SkydivinGirl/SaV64/README.md

# SaV64
Commodore VIC-20, Commodore 64, and Commodore Plus/4 Over-Voltage Protection

Jointly designed by Heather Kent and Fredric Blåholtz

Electrical Design and PCB Layout: Fredric Blåholtz
