SkydivinGirl/SaV64/PCBs/Oops v3/ReadMe.txt

Optocoupler Daughter Board for SaV64 v1.33 PCB
