SkydivinGirl/SaV64/Documents/Trip Point Settings.txt

5.628V = 43K
5.573V = 43K + (698 Parallel 1.8K = 503)
5.552V = 43K + 698
5.437V = 43K + 1.8K
