SkydivinGirl/SaV64/PCBs/v1.33/ReadMe.txt

SaV64 v1.33 PCB
Requires Oops v3 Optocoupler Daughter Board
