SkydivinGirl/SaV64/Images/20150811_192422.jpg

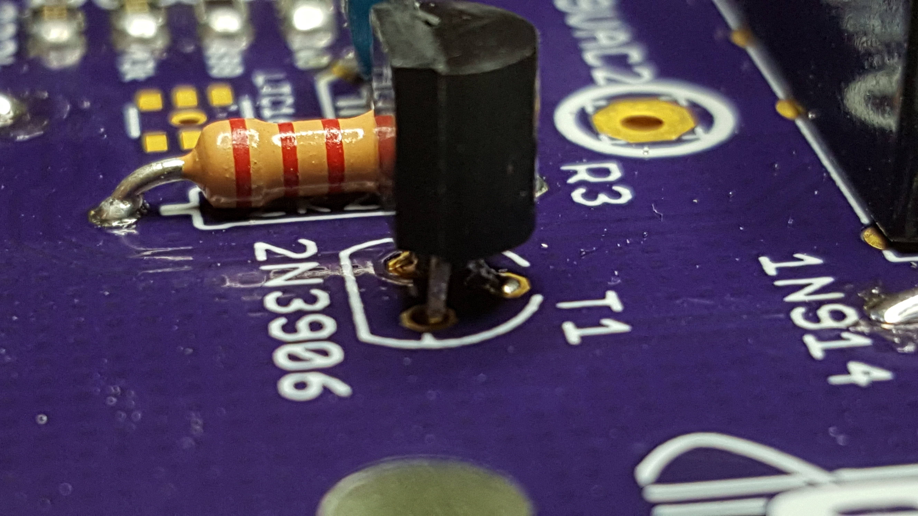
Images/20150811_192422.jpg
