SkydivinGirl/SaV64/Images/20150816_183255.jpg

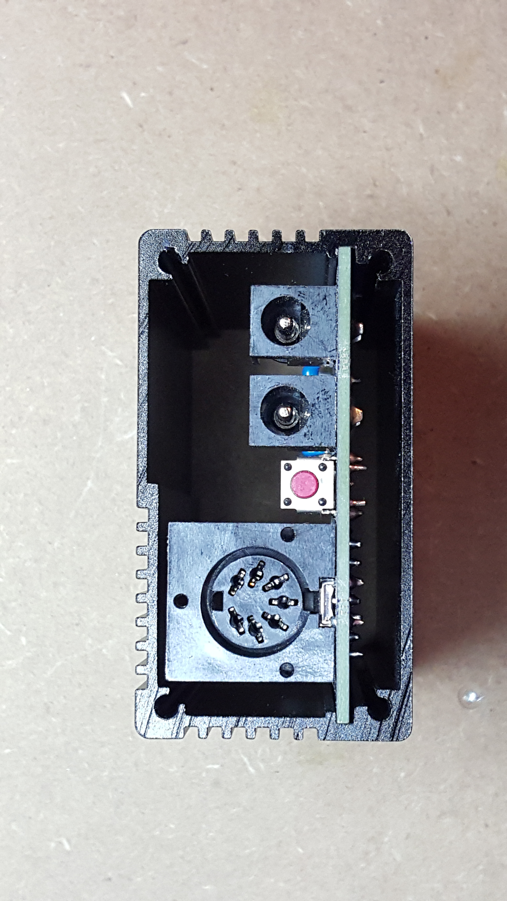
Images/20150816_183255.jpg
