SkydivinGirl/SaV64/Images/20150816_202436.jpg

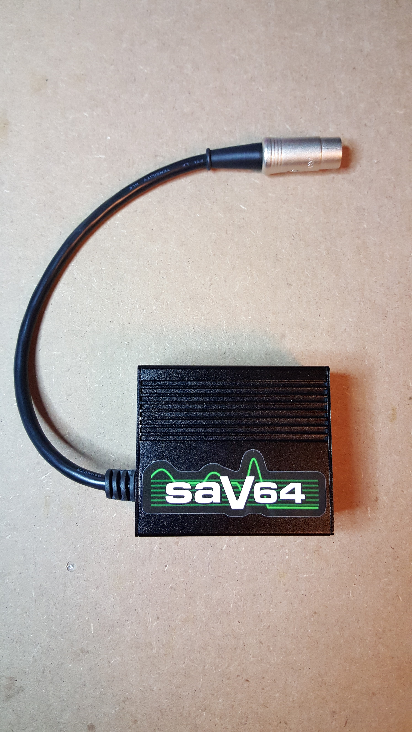
Images/20150816_202436.jpg
