SkydivinGirl/SaV64/Images/20150816_202522.jpg

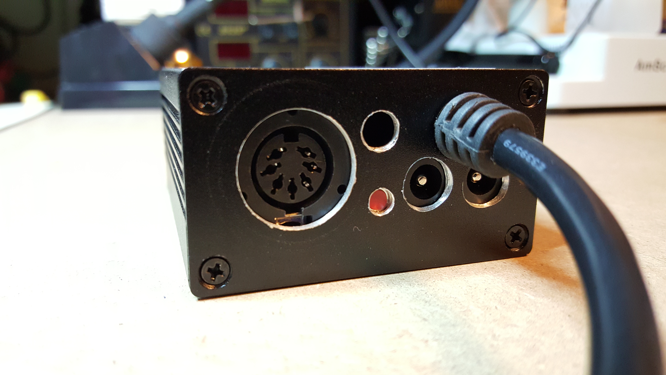
Images/20150816_202522.jpg
