SkydivinGirl/SaV64/Images/20150819_134136_original.jpg

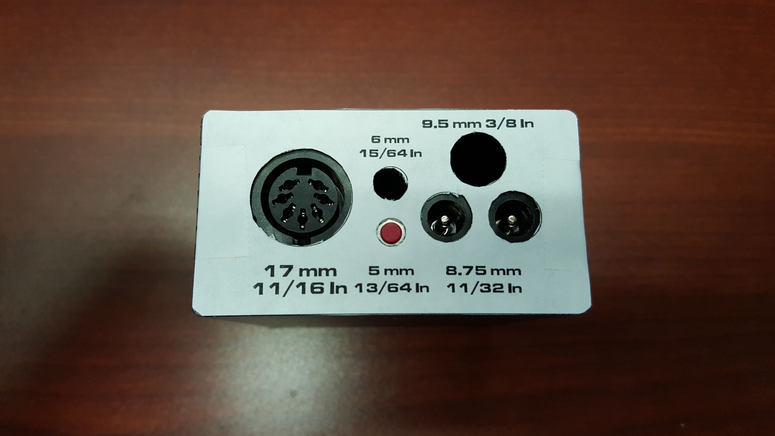
Images/20150819_134136_original.jpg
