SkydivinGirl/SaV64/Images/End Plate Labels/Bottom Plate Label 5.44 with Polarity.png

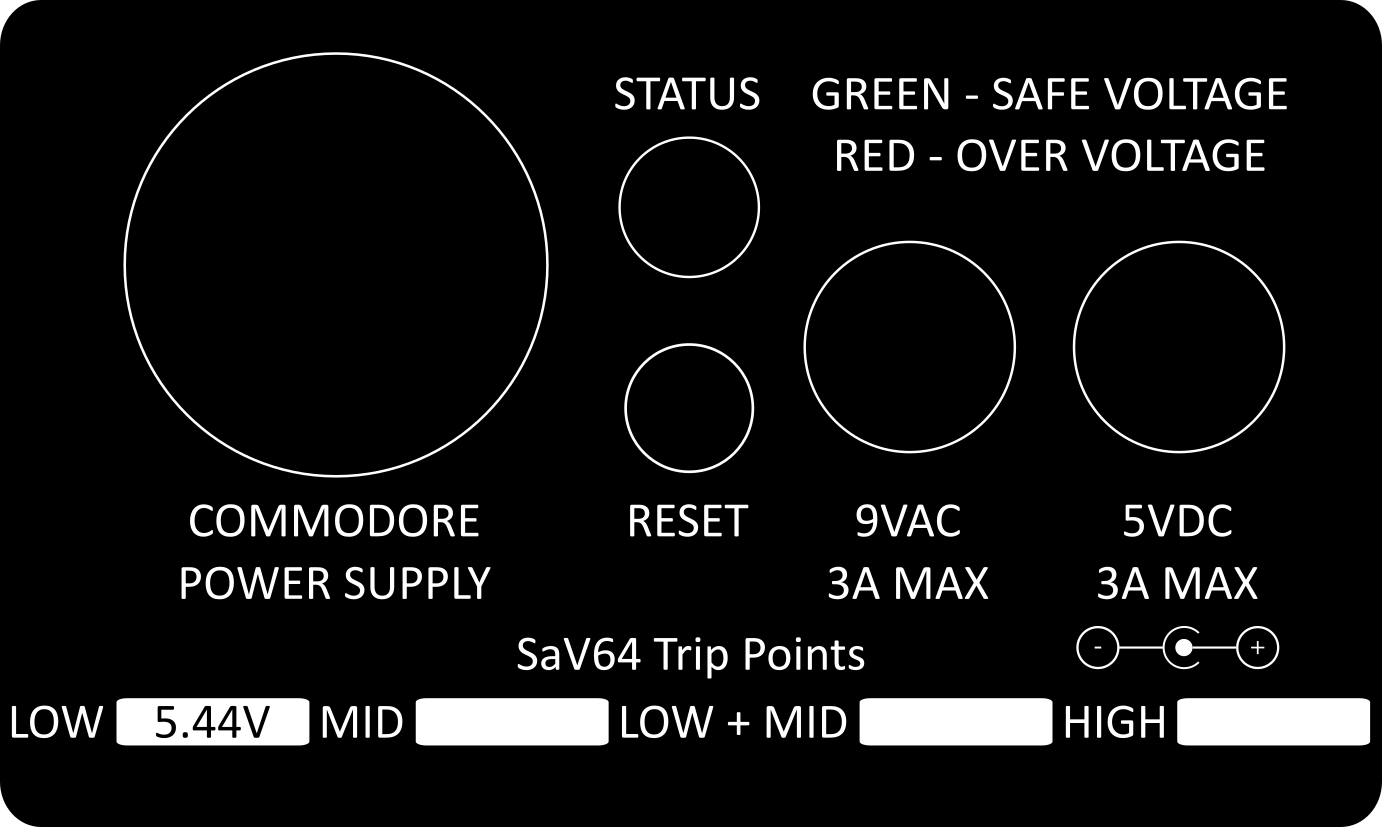
Images/End Plate Labels/Bottom Plate Label 5.44 with Polarity.png
