SkydivinGirl/SaV64/Images/End Plate Template (With Image).jpg

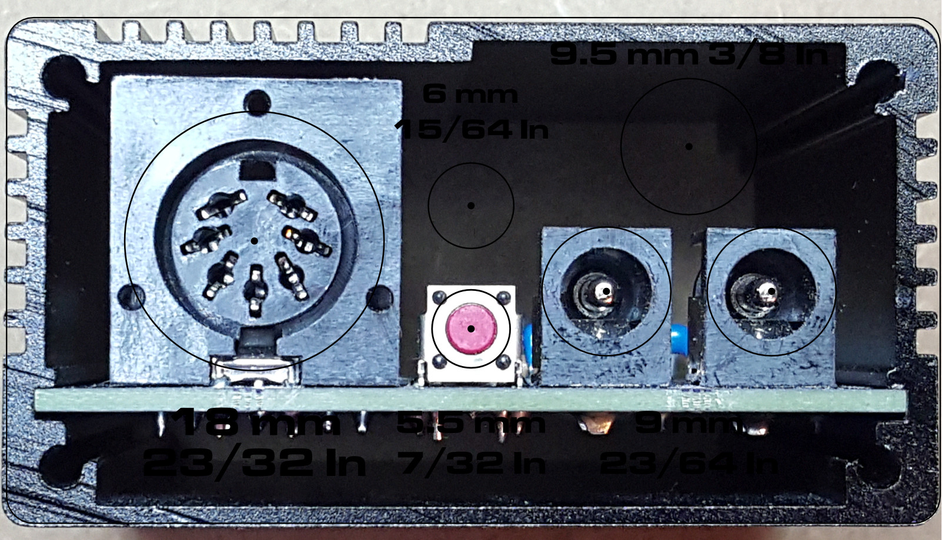
Images/End Plate Template (With Image).jpg
