SkydivinGirl/SaV64/Images/Sample 1.jpg

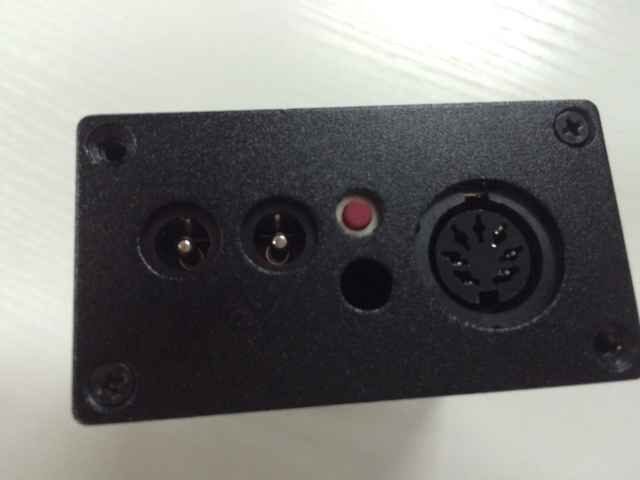
Images/Sample 1.jpg
