SkydivinGirl/SaV64/Images/Sample 2.jpg

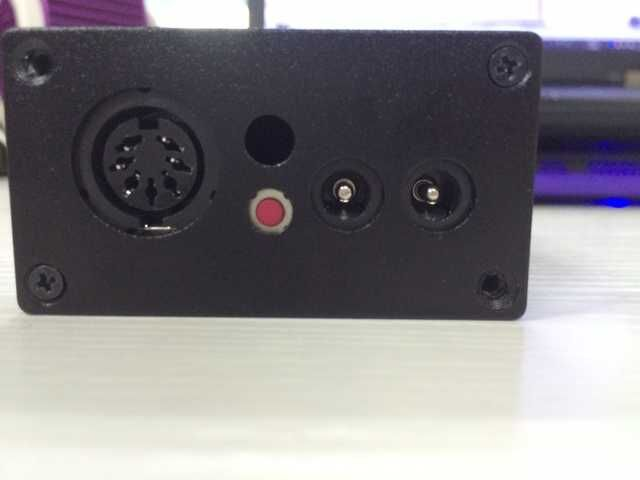
Images/Sample 2.jpg
