SkydivinGirl/SaV64/Images/SaV64 Stickers Shipped.jpg

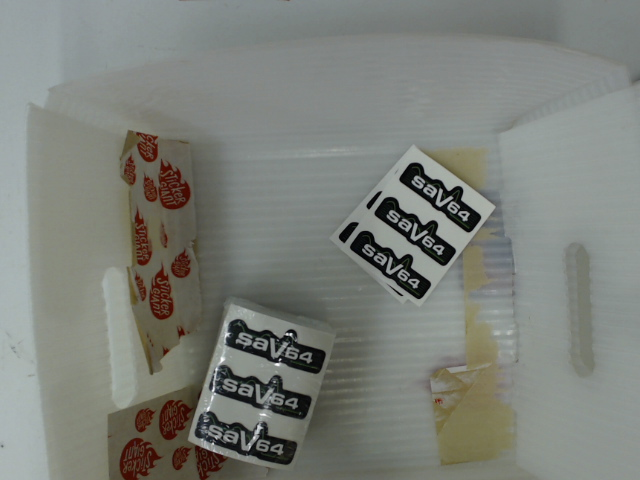
Images/SaV64 Stickers Shipped.jpg
