SkydivinGirl/SaV64/Images/saver schematic.jpg

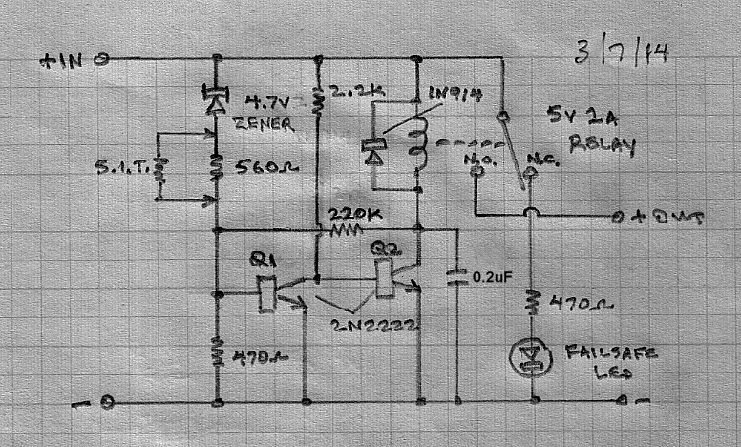
Images/saver schematic.jpg
