SkydivinGirl/SaV64/PCBs/Oops v3/EagleUp/eagleUp_SaV64_v133_oops_board_bottom.png

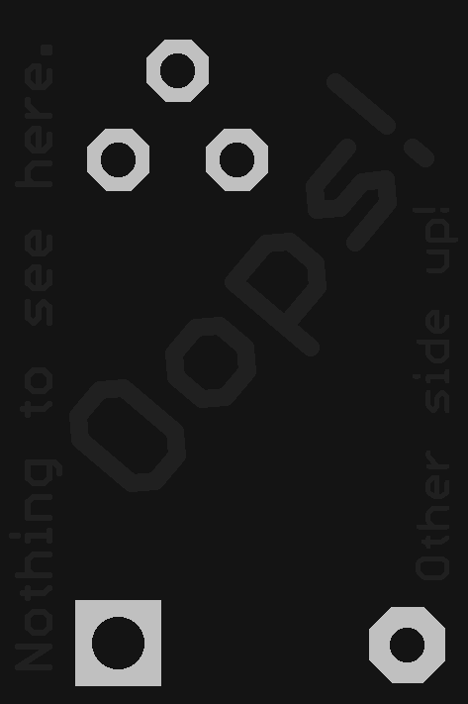
PCBs/Oops v3/EagleUp/eagleUp_SaV64_v133_oops_board_bottom.png
