SkydivinGirl/SaV64/PCBs/Oops v3/Ooops3.png

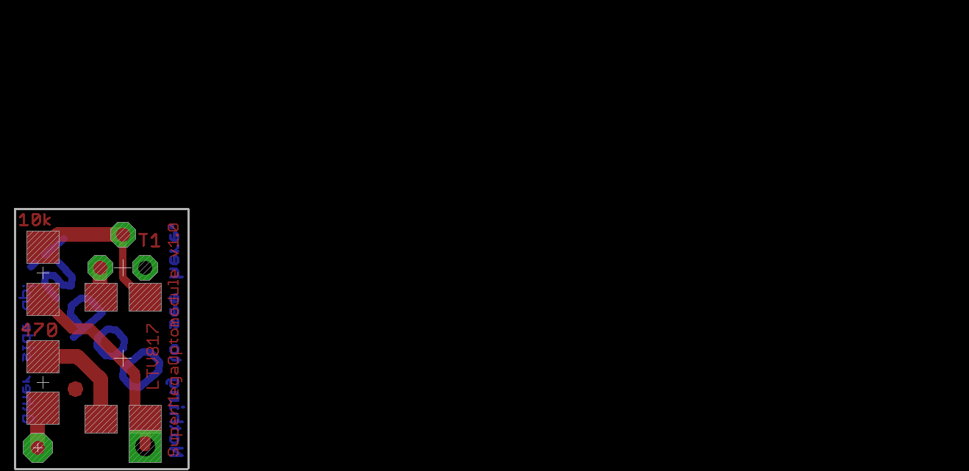
PCBs/Oops v3/Ooops3.png
