SkydivinGirl/SaV64/Documents/SaV64 BOM.xlsx

Qty | Loc | Markings | Description | Manufacturer # | DigiKey # | Mouser # | Notes | DK Price | DK Total | Mous Price | Mous Total
1 | R1 | 433 | RES SMD 43K OHM 0.1% 1/10W 0805 | 9-1614884-5 | A103208CT-ND | 667-ERA-6AEB433V | ERA-6AEB433V | $0.65 | $0.65 | $0.63 | $0.63
1 | R2 |  | RES SMD 232K OHM 0.1% 1/4W 0805 | 2-2176094-8 | A110770CT-ND | 667-ERA-6AEB2323V | ERA-6AEB2323V | $0.76 | $0.76 | $0.63 | $0.63
1 | R3 | 4700 | RES SMD 470 OHM 1% 1/8W 0805 | RT0805FRE07470RL |  | 603-RT0805FRE07470RL |  |  | $0.00 | $0.12 | $0.12
1 | R4 | 182 | RES SMD 1.8K OHM 0.1% 1/10W 0805 | 6-1614884-8 | A103171CT-ND | 667-ERA-6AEB182V | ERA-6AEB182V | $0.14 | $0.14 | $0.63 | $0.63
1 | R6 |  | RES SMD 698 OHM 0.1% 1/4W 0805 | 2176092-4 | A110528CT-ND | 667-ERA-6AEB6980V | ERA-6AEB6980V | $0.76 | $0.76 | $0.63 | $0.63
1 | R7 | 103 | RES SMD 10K OHM 0.1% 1/8W 0805 | ERA-6AEB103V | P10KDACT-ND | 667-ERA-6AEB103V |  | $0.63 | $0.63 | $0.63 | $0.63
1 | U1 |  | IC OVERVOLT PROT CTRLR SOT23-6 | LTC1696ES6#TRMPBF | LTC1696ES6#TRMPBFCT-ND |  |  | $4.02 | $4.02
1 |  |  | Daughterboard PCB
1 | T1 |  | TRANS PNP 40V 0.2A TO-92 | 2N3906TA | 2N3906TAFSCT-ND | 512-2N3906TA |  | $0.21 | $0.21 | $0.21 | $0.21
1 | U2 |  | OPTOISOLATR 5KV TRANSISTOR 4-SMD | LTV-817S | 160-1367-5-ND | 859-LTV-817S |  | $0.45 | $0.45 | $0.24 | $0.24
1 | C1 | 105 | CAP CER 1UF 10V 10% RADIAL | FK28X5R1A105K | 445-2851-ND | 810-FK28X5R1A105K |  | $0.32 | $0.32 | $0.32 | $0.32
2 | C2,C3 | 104 | CAP CER 0.1UF 25V 10% RADIAL | FK28X7R1E104K | 445-8618-ND | 810-FK28X7R1E104K |  | $0.30 | $0.60 | $0.30 | $0.60
1 | C4 | 106 | CAP CER 10UF 10V 10% RADIAL | FK24X5R1A106K | 445-8493-ND | 810-FK24X5R1A106K |  | $0.46 | $0.46 | $0.46 | $0.46
1 | D1 |  | DIODE GEN PURP 100V 200MA DO3 | 1N914 | 1N914FS-ND | 512-1N914 |  | $0.10 | $0.10 | $0.10 | $0.10
1 | R5 | Y,V,BR,G | RES 470 OHM 1/2W 5% AXIAL | CFR-50JB-52-470R | 470H-ND | 279-CFR50J470R | CFR50J470R | $0.10 | $0.10 | $0.10 | $0.10
2 | F1 |  | FUSE CLIP CART 250V 6.3A PCB | 0751.0110 | 486-2019-ND | 693-0751.0110 |  | $0.14 | $0.28 | $0.12 | $0.24
1 | F1 |  | FUSE GLASS 3.15A 125VAC 5X20MM | 5TT 3.15-R | 507-1565-ND | 530-5TT3.15-R |  | $0.29 | $0.29 | $0.28 | $0.28
1 | LED2 |  | LED IND 5MM RED/GRN WHT DIFF | WP59EGW | 754-1232-ND | 604-WP59EGW |  | $0.44 | $0.44 | $0.33 | $0.33
1 | LED2 |  | HOLDER LED PANEL 5MM BLACK NYLON | SSH-LX5091 | 67-1332-ND | 696-SSH-LX5091 |  | $0.21 | $0.21 | $0.34 | $0.34
1 | S1 |  | SWITCH TACTILE SPST-NO 0.05A 12V | TL1105VF250Q | EG2509-ND | 612-TL1105VF250Q |  | $0.35 | $0.35 | $0.35 | $0.35
1 |  |  | 6mm BLACK 3/32" Polyolefin 2:1 Heat Shrink Tubing |  |  |  |  |  |  | $0.06 | $0.06
1 | X1 |  | CONN DIN 7 PIN FEMALE PCB | SDS-70J | CP-2370-ND | 490-SDS-70J | 2 Amp | $1.75 | $1.75 | $1.74 | $1.74
1 | K1 |  | RELAY TELECOM DPDT 3A 5V | 8-1393792-5 | PB383-ND | 655-V23105A5001A201 |  | $1.60 | $1.60 | $1.55 | $1.55
1 | X2 |  | TERMINAL BLOCK 5.08MM 2POS PCB | OSTTG025100B | ED2703-ND |  |  | $0.48 | $0.48
1 |  |  | Mini Rubber Strain Relief Cord Boot Protector Cable Sleeve Hose |  |  |  |  |  |  | $0.25 | $0.25
2 | J1/J2 |  | CON PWR JCK 2.0 X 6.3MM HIGH CUR | PJ-057AH | CP-057AH-ND | 490-PJ-057AH |  | $1.19 | $2.38 | $1.18 | $2.36
2 | J1/J2 |  | CON PWR JCK 2.5 X 6.3MM HIGH CUR | PJ-057BH | CP-057BH-ND | 490-PJ-057BH |  | $1.19 | $2.38 | $1.18 | $2.36
1 |  |  | SZOMK AK-C-C17 (35 x 65 x 72mm) | AK-C-B17 |  |  |  |  |  | $7.50 | $7.50
1 |  |  | PCB |  |  |  |  |  |  | $2.50 | $2.50
1 |  |  | Sticker |  |  |  |  |  |  | $0.50 | $0.50
4 |  |  | 3M Rubber Bumper Pads Self Adhesive Anti Skid Feet Bumpon SJ-5007 |  |  | 517-SJ-5007BK |  |  |  | $0.04 | $0.16
2 |  |  | Cable Ties
1 |  |  | Circular DIN Connectors 7P MALE PLUG - DIN 270 NICKEL/GOLD REAN | NYS323G |  | 568-NYS323G |  | $1.45 | $1.45
1 |  |  | CABLE 4COND 18AWG BLACK 1M | 30-00380 | T1281-1-ND |  |  | $3.66 | $3.66
