SkydivinGirl/SaV64/(list of files, cad)

Other CAD files:
PCBs/Oops v3/SaV64_v133_oops.skp
