SkydivinGirl/SaV64/Documents/SaV64 Assembly.docx

SaV64 Assembly

Bill of Materials

[url=http://postimg.org/image/3uxn0z22d/][img]http://s2.postimg.org/3uxn0z22d/Sa_V64_Assembly_001.jpg[/img][/url]

Qty | Loc | Markings | Description
1 | C1 | 105 | CAP CER 1UF 10V 10% RADIAL
2 | C2,C3 | 104 | CAP CER 0.1UF 25V 10% RADIAL
1 | C4 | 106 | CAP CER 10UF 10V 10% RADIAL
1 | D1 | | DIODE GEN PURP 100V 200MA DO3
2 | F1 | | FUSE CLIP CART 250V 6.3A PCB
1 | F1 | | FUSE GLASS 3.15A 125VAC 5X20MM
2 | J1/J2 | | CON PWR JCK HIGH CUR
1 | K1 | | RELAY TELECOM DPDT 3A 5V
1 | LED2 | | LED IND 5MM RED/GRN WHT DIFF
1 | LED2 | | HOLDER LED PANEL 5MM BLACK NYLON
1 | R1 | 433 | RES SMD 43K OHM 0.1% 1/10W 0805
1 | R2 | | RES SMD 232K OHM 0.1% 1/4W 0805
1 | R3 | 4700 | RES SMD 470 OHM 1% 1/8W 0805
1 | R4 | 182 | RES SMD 1.8K OHM 0.1% 1/10W 0805
1 | R5 | Y,V,BR,G | RES 470 OHM 1/2W 5% AXIAL
1 | R6 | | RES SMD 698 OHM 0.1% 1/4W 0805
1 | R7 | 103 | RES SMD 10K OHM 0.1% 1/8W 0805
1 | S1 | | SWITCH TACTILE SPST-NO 0.05A 12V
1 | T1 | | TRANS PNP 40V 0.2A TO-92
1 | U1 | | IC OVERVOLT PROT CTRLR SOT23-6
1 | U2 | | OPTOISOLATR 5KV TRANSISTOR 4-SMD
1 | X1 | | CONN DIN 7 PIN FEMALE PCB
1 | X2 | | TERMINAL BLOCK 5.08MM 2POS PCB
1 | | | Circular DIN Connectors 7P MALE PLUG - DIN 270 NICKEL/GOLD REAN
1 | | | CABLE 4COND 18AWG BLACK 20 Inch
1 | | | 6cm BLACK 3/32" Polyolefin 2:1 Heat Shrink Tubing
2 | | | PCB (Main, Daughter Board)
1 | | | Case
4 | | | 3M Rubber Bumper Pads Self Adhesive Anti Skid Feet
1 | | | Mini Rubber Strain Relief Cord Boot Protector Cable Sleeve Hose
1 | | | Stickers

Daughter Board Assembly

Use the daughter board PCB, Optoisolator (U2), 470 Ohm Resistor (R3), 10K Ohm Resistor (R7), and Transistor (T1) to assemble the daughter board.

[url=http://postimg.org/image/ulqn7cv4r/][img]http://s1.postimg.org/ulqn7cv4r/Sa_V64_Assembly_002.jpg[/img][/url]

The legs of the Optoisolator need to be bent in towards the chip so they will fit on the daughter board PCB pads. Prepare the transistor by straightening the outside legs then bend the center leg towards the back of the resistor.

[url=http://postimg.org/image/sq3uw76aj/][img]http://s1.postimg.org/sq3uw76aj/Sa_V64_Assembly_003.jpg[/img][/url] [url=http://postimg.org/image/y42n3qw0r/][img]http://s1.postimg.org/y42n3qw0r/Sa_V64_Assembly_004.jpg[/img][/url]

When soldering the Optoisolator, be certain you do not let solder fill the holes in the PCB. Next, attach the resistors. Finally, insert the transistor into the daughter board. DO NOT cut the legs. Solder the transistor while not allowing too much solder to build up around the legs. Solder build up will keep the daughter board from sitting flush against the main PCB.

[url=http://postimg.org/image/aokpyec9n/][img]http://s1.postimg.org/aokpyec9n/Sa_V64_Assembly_005.jpg[/img][/url]

Primary Board Assembly

Attach the SMD components (R1, R2, R4, R6, and U1) to the primary PCB.

[url=http://postimg.org/image/rg61h5cij/][img]http://s1.postimg.org/rg61h5cij/Sa_V64_Assembly_006.jpg[/img][/url]

Fit the daughter board to the primary PCB by inserting the transistor pins from the daughter board into the transistor location on the primary PCB (T1).

[url=http://postimg.org/image/9ty6cd4ez/][img]http://s1.postimg.org/9ty6cd4ez/Sa_V64_Assembly_007.jpg[/img][/url]

The daughter board requires a Ground connection that can be obtained in one of two ways. The first (recommended) way is by scraping away some solder mask under the daughter board to get to the ground plane. With the daughter board in place, use a pin to scratch into the ground plane through the hole in the daughter board near the Optoisolator. Remove the daughter board to scrape away a good size area.

[url=http://postimg.org/image/vjqnxt66d/][img]http://s10.postimg.org/vjqnxt66d/Sa_V64_Assembly_008.jpg[/img][/url]

Once the solder mask is scraped away, place a solder blob on the ground plane in the scraped off area. Re-attach the daughter board then place a pin in the opposite hole (near the LTC chip) to hold the daughter board in place. I use a pin like the following:

[url=http://postimg.org/image/tfe5k3kih/][img]http://s12.postimg.org/tfe5k3kih/PIN.jpg[/img][/url]

While pushing the daughter board towards the primary PCB, heat the ground pad with your soldering iron. The solder blob on the ground plane below will melt and attach to the daughter board. Fill the rest of the hole with solder. Solder the transistor to the primary PCB and trim the legs. Remove the pin you used to hold the daughter board in place then fill the hole all the way through the daughter board and primary PCB with solder.

[url=http://postimg.org/image/9so8iy2l7/][img]http://s1.postimg.org/9so8iy2l7/Sa_V64_Assembly_009.jpg[/img][/url]

An alternative way to get ground to the daughter board is to run a jumper wire from Ground on the daughter board to another Ground location. The closest suggested attachment point is the ground side of C2. The ground side is the side closest to the edge of the PCB.

Attach the capacitors (C1, C2, C3, C4), resistor (R5), Diode (D1), and fuse holders. When attaching the fuse holders, be sure the end of the each holder that has the tab is facing towards the outside of the PCB. Wiggle the fuse holders while inserting them into the PCB in order to get them straight and flush with the PCB.

[url=http://postimg.org/image/ojnlulw2j/][img]http://s1.postimg.org/ojnlulw2j/Sa_V64_Assembly_010.jpg[/img][/url]

Next, attach the relay (K1) and the terminal block (X2). Completely tighten the two screws on the terminal block before soldering it to the PCB.

[url=http://postimg.org/image/y6r44bp23/][img]http://s1.postimg.org/y6r44bp23/Sa_V64_Assembly_011.jpg[/img][/url]

Attach the DIN connector (X1), reset switch (S1), and barrel jacks (J1, J2).

[url=http://postimg.org/image/nind5hf2z/][img]http://s1.postimg.org/nind5hf2z/Sa_V64_Assembly_012.jpg[/img][/url]

The AC and DC barrel connectors are disconnected by default. In order to connect them, use solder blobs to bridge across the gaps in the tracks. The AC gap is on the top of the PCB and the DC gap is on the bottom.

[url=http://postimg.org/image/be83oi26z/][img]http://s1.postimg.org/be83oi26z/Sa_V64_Assembly_013.jpg[/img][/url] [url=http://postimg.org/image/o1nv10h3v/][img]http://s1.postimg.org/o1nv10h3v/Sa_V64_Assembly_014.jpg[/img][/url]

Output Cable Assembly

Find the end of the 4-Wire cable that has the colors in the same order as the image below.

[url=http://postimg.org/image/5c0gy0dqz/][img]http://s1.postimg.org/5c0gy0dqz/Sa_V64_Assembly_015.jpg[/img][/url]

This is the end of the cable that attaches to the DIN connector. Trim 20mm of the outer casing from this end of the cable. Trim 45mm of the outer casing from the other end of the cable. Cut the heat shrink tubing into 9mm pieces.

[url=http://postimg.org/image/7rxoy46fv/][img]http://s1.postimg.org/7rxoy46fv/Sa_V64_Assembly_016.jpg[/img][/url]

Solder the DIN side of the cable to the output DIN connector using the following layout. This image shows the connector on the solder side. Be sure to put a piece of heat shrink tubing on each wire before attaching them to the DIN connector.

[url=http://postimg.org/image/3pjg6510v/][img]http://s27.postimg.org/3pjg6510v/DIN_Solder_Side.jpg[/img][/url]

After attaching all the wires, push the heat shrink tubing over the solder joints then heat them to shrink the tubing. I would also suggest wrapping all the wires in a little electrical tape or a large piece of heat shrink tubing to add a little extra protection as parts of the DIN stain reliever may have slightly sharp edges. Attach the strain reliever then carefully bend the tabs over the wires. Slide the cover onto the wire then screw it down to the strain reliever.

[url=http://postimg.org/image/bw394crrv/][img]http://s1.postimg.org/bw394crrv/Sa_V64_Assembly_017.jpg[/img][/url]

Drill a hole into either end plate depending on where you want the output wire to come out of the SaV64. I would suggest using a bit that is between 9mm and 10mm. A larger hole is easier to insert the rubber grommet into but provides a looser fit. A smaller hole has a tighter fit but is more difficult to get the rubber grommet into without marring the rubber.

[url=http://postimg.org/image/5m7zhcsd7/][img]http://s1.postimg.org/5m7zhcsd7/Sa_V64_Assembly_018.jpg[/img][/url]

From the inner side of the end plate, insert the rubber strain relief into the hole you drilled. Lightly attach a zip tie around the rubber boot. Do not tighten it. Run the output cable through the boot.

[url=http://postimg.org/image/4xz4yetnf/][img]http://s1.postimg.org/4xz4yetnf/Sa_V64_Assembly_019.jpg[/img][/url]

Trim 5mm off each of the four output wires except the yellow wire.

[url=http://postimg.org/image/xwjlkzafv/][img]http://s1.postimg.org/xwjlkzafv/Sa_V64_Assembly_020.jpg[/img][/url]

Attach the wires to the PCB as shown below. The wires are a very tight fit in the PCB. Simply strip the wire then insert it into the PCB. Do not tin or twist the wires because it will make the wires bigger and more difficult to insert in the holes.

Black: Ground

Yellow: 5VDC

White: 9VAC

Red: 9VAC

[url=http://postimg.org/image/5df0564yj/][img]http://s1.postimg.org/5df0564yj/Sa_V64_Assembly_021.jpg[/img][/url]

Hold the LED with the long leg on the right hand side then bend the LED at a 90 degree angle towards you. The bend point is marked in red. After that, cut all the legs to the same length and attach the LED to the PCB. The LED should only be inserted far enough into the PCB to be soldered.

[url=http://postimg.org/image/qgro1s2ll/][img]http://s4.postimg.org/qgro1s2ll/Sa_V64_Assembly_022.jpg[/img][/url]

Insert the fuse and attach the output cable to the PCB using a zip tie. If the output wire is going out the same end as the inputs then you can tighten the zip tie completely. If going out the opposite end, attach the cable tie very loosely until later when the end plate is in place.

Add a solder blob across the two pads for the LOW trip point.

[url=http://postimg.org/image/5mfbjy889/][img]http://s4.postimg.org/5mfbjy889/Sa_V64_Assembly_023.jpg[/img][/url]

Case Assembly (Input & Output Same Side)

Attach the LED holder to the end plate then slide the plate and stress reliever on the output cable towards the PCB. Move the rubber stress reliever on top of the barrel connectors. Align the LED with the LED holder and push it forward into the holder. Once the cable is where you want it, tighten and trim the zip tie.

[url=http://postimg.org/image/az45y2w4p/][img]http://s4.postimg.org/az45y2w4p/Sa_V64_Assembly_024.jpg[/img][/url]

Attach and screw in the blank end plate to the main case then slide the PCB into the other end of the case. You will have to wiggle and adjust the output cable to get things to line up. You can get everything centered fairly well with a little effort.

[url=http://postimg.org/image/htbpywyaj/][img]http://s1.postimg.org/htbpywyaj/Sa_V64_Assembly_025.jpg[/img][/url]

Attach the SaV64 sticker.

[url=http://postimg.org/image/edjlpd123/][img]http://s1.postimg.org/edjlpd123/Sa_V64_Assembly_026.jpg[/img][/url]

Case Assembly (Input & Output Opposite Sides)

Slide the plate and stress reliever on the output cable towards the PCB. Move the rubber stress reliever on top of the PCB then tighten and trim both zip ties.

[url=http://postimg.org/image/k2zu9o78b/][img]http://s1.postimg.org/k2zu9o78b/Sa_V64_Assembly_027.jpg[/img][/url]

Insert the PCB into the case and tighten down the end plate. Pull the LED a little ways out of the other end of the case.

[url=http://postimg.org/image/ec9nvxz8b/][img]http://s1.postimg.org/ec9nvxz8b/Sa_V64_Assembly_028.jpg[/img][/url]

Attach the LED holder to the end plate then push the LED into the holder. You can use a small screwdriver on the back plastic area of the LED to make it easier. Once the LED is attached, screw the end plate to the case.

[url=http://postimg.org/image/j39jdys2j/][img]http://s1.postimg.org/j39jdys2j/Sa_V64_Assembly_029.jpg[/img][/url]

Attach the SaV64 sticker.

[url=http://postimg.org/image/eg3hc74pn/][img]http://s1.postimg.org/eg3hc74pn/Sa_V64_Assembly_030.jpg[/img][/url]

Final Steps

Attach the rubber feet and layout sticker to the bottom of the case.

[url=http://postimg.org/image/eincz18d7/][img]http://s1.postimg.org/eincz18d7/Sa_V64_Assembly_031.jpg[/img][/url]
