SkydivinGirl/SaV64/Documents/PostImage Assembly Links.txt

[url=http://postimg.org/image/3uxn0z22d/][img]http://s2.postimg.org/3uxn0z22d/Sa_V64_Assembly_001.jpg[/img][/url]

[url=http://postimg.org/image/ulqn7cv4r/][img]http://s1.postimg.org/ulqn7cv4r/Sa_V64_Assembly_002.jpg[/img][/url]

[url=http://postimg.org/image/sq3uw76aj/][img]http://s1.postimg.org/sq3uw76aj/Sa_V64_Assembly_003.jpg[/img][/url]

[url=http://postimg.org/image/y42n3qw0r/][img]http://s1.postimg.org/y42n3qw0r/Sa_V64_Assembly_004.jpg[/img][/url]

[url=http://postimg.org/image/aokpyec9n/][img]http://s1.postimg.org/aokpyec9n/Sa_V64_Assembly_005.jpg[/img][/url]

[url=http://postimg.org/image/rg61h5cij/][img]http://s1.postimg.org/rg61h5cij/Sa_V64_Assembly_006.jpg[/img][/url]

[url=http://postimg.org/image/9ty6cd4ez/][img]http://s1.postimg.org/9ty6cd4ez/Sa_V64_Assembly_007.jpg[/img][/url]

[url=http://postimg.org/image/vjqnxt66d/][img]http://s10.postimg.org/vjqnxt66d/Sa_V64_Assembly_008.jpg[/img][/url]

[url=http://postimg.org/image/9so8iy2l7/][img]http://s1.postimg.org/9so8iy2l7/Sa_V64_Assembly_009.jpg[/img][/url]

[url=http://postimg.org/image/ojnlulw2j/][img]http://s1.postimg.org/ojnlulw2j/Sa_V64_Assembly_010.jpg[/img][/url]

[url=http://postimg.org/image/y6r44bp23/][img]http://s1.postimg.org/y6r44bp23/Sa_V64_Assembly_011.jpg[/img][/url]

[url=http://postimg.org/image/nind5hf2z/][img]http://s1.postimg.org/nind5hf2z/Sa_V64_Assembly_012.jpg[/img][/url]

[url=http://postimg.org/image/be83oi26z/][img]http://s1.postimg.org/be83oi26z/Sa_V64_Assembly_013.jpg[/img][/url]

[url=http://postimg.org/image/o1nv10h3v/][img]http://s1.postimg.org/o1nv10h3v/Sa_V64_Assembly_014.jpg[/img][/url]

[url=http://postimg.org/image/5c0gy0dqz/][img]http://s1.postimg.org/5c0gy0dqz/Sa_V64_Assembly_015.jpg[/img][/url]

[url=http://postimg.org/image/7rxoy46fv/][img]http://s1.postimg.org/7rxoy46fv/Sa_V64_Assembly_016.jpg[/img][/url]

[url=http://postimg.org/image/bw394crrv/][img]http://s1.postimg.org/bw394crrv/Sa_V64_Assembly_017.jpg[/img][/url]

[url=http://postimg.org/image/5m7zhcsd7/][img]http://s1.postimg.org/5m7zhcsd7/Sa_V64_Assembly_018.jpg[/img][/url]

[url=http://postimg.org/image/4xz4yetnf/][img]http://s1.postimg.org/4xz4yetnf/Sa_V64_Assembly_019.jpg[/img][/url]

[url=http://postimg.org/image/xwjlkzafv/][img]http://s1.postimg.org/xwjlkzafv/Sa_V64_Assembly_020.jpg[/img][/url]

[url=http://postimg.org/image/5df0564yj/][img]http://s1.postimg.org/5df0564yj/Sa_V64_Assembly_021.jpg[/img][/url]

[url=http://postimg.org/image/qgro1s2ll/][img]http://s4.postimg.org/qgro1s2ll/Sa_V64_Assembly_022.jpg[/img][/url]

[url=http://postimg.org/image/5mfbjy889/][img]http://s4.postimg.org/5mfbjy889/Sa_V64_Assembly_023.jpg[/img][/url]

[url=http://postimg.org/image/az45y2w4p/][img]http://s4.postimg.org/az45y2w4p/Sa_V64_Assembly_024.jpg[/img][/url]

[url=http://postimg.org/image/htbpywyaj/][img]http://s1.postimg.org/htbpywyaj/Sa_V64_Assembly_025.jpg[/img][/url]

[url=http://postimg.org/image/edjlpd123/][img]http://s1.postimg.org/edjlpd123/Sa_V64_Assembly_026.jpg[/img][/url]

[url=http://postimg.org/image/k2zu9o78b/][img]http://s1.postimg.org/k2zu9o78b/Sa_V64_Assembly_027.jpg[/img][/url]

[url=http://postimg.org/image/ec9nvxz8b/][img]http://s1.postimg.org/ec9nvxz8b/Sa_V64_Assembly_028.jpg[/img][/url]

[url=http://postimg.org/image/j39jdys2j/][img]http://s1.postimg.org/j39jdys2j/Sa_V64_Assembly_029.jpg[/img][/url]

[url=http://postimg.org/image/eg3hc74pn/][img]http://s1.postimg.org/eg3hc74pn/Sa_V64_Assembly_030.jpg[/img][/url]

[url=http://postimg.org/image/eincz18d7/][img]http://s1.postimg.org/eincz18d7/Sa_V64_Assembly_031.jpg[/img][/url]
