SkydivinGirl/SaV64/Images/Assembly Images/DIN (Solder Side).png

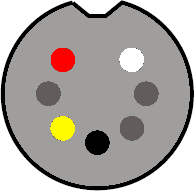
Images/Assembly Images/DIN (Solder Side).png
