SkydivinGirl/SaV64/Images/Assembly Images/PIN.jpg

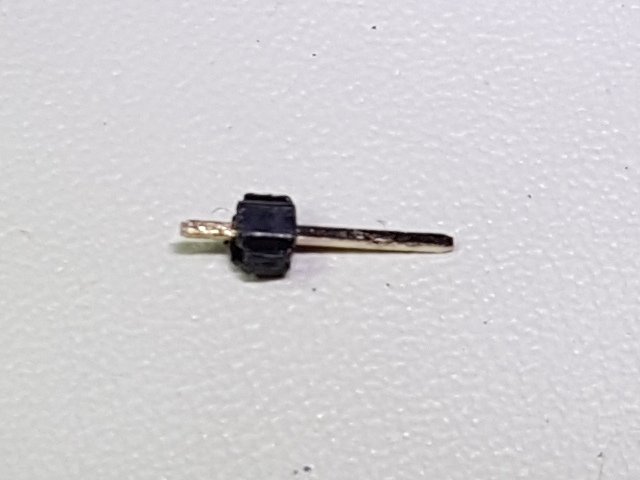
Images/Assembly Images/PIN.jpg
