SkydivinGirl/SaV64/Images/Assembly Images/SaV64 Assembly 001.jpg

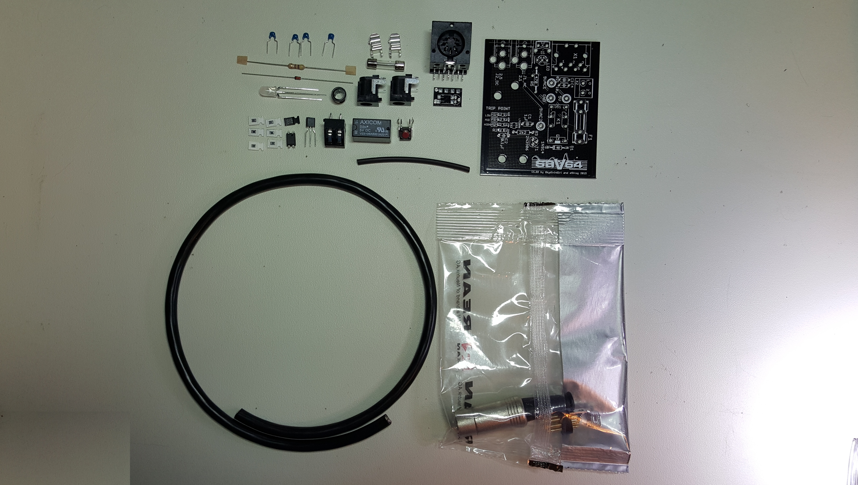
Images/Assembly Images/SaV64 Assembly 001.jpg
