SkydivinGirl/SaV64/Images/Assembly Images/SaV64 Assembly 002.jpg

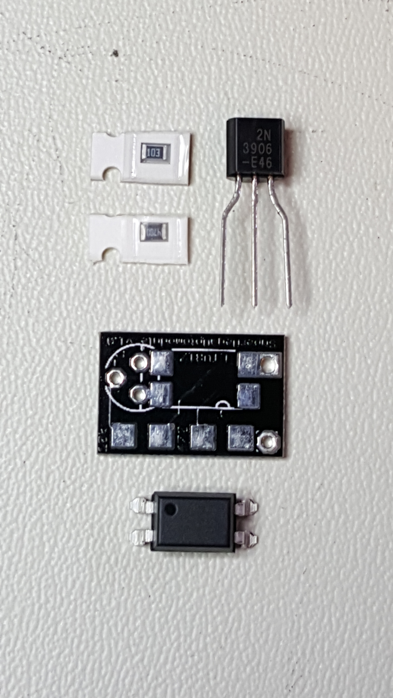
Images/Assembly Images/SaV64 Assembly 002.jpg
