SkydivinGirl/SaV64/Images/Assembly Images/SaV64 Assembly 003.jpg

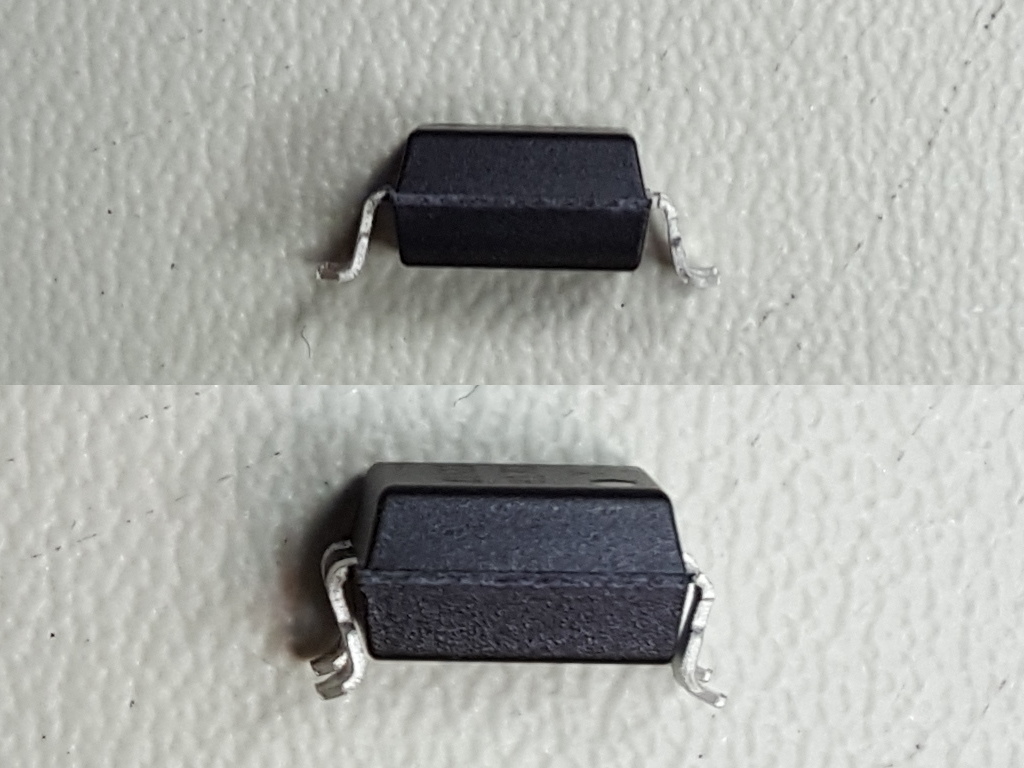
Images/Assembly Images/SaV64 Assembly 003.jpg
