SkydivinGirl/SaV64/Images/Assembly Images/SaV64 Assembly 004.jpg

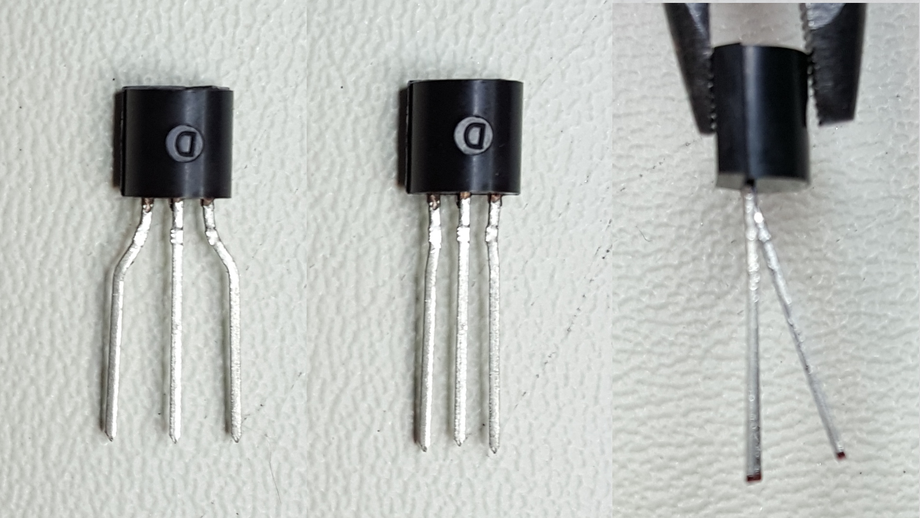
Images/Assembly Images/SaV64 Assembly 004.jpg
