SkydivinGirl/SaV64/Images/Assembly Images/SaV64 Assembly 005.jpg

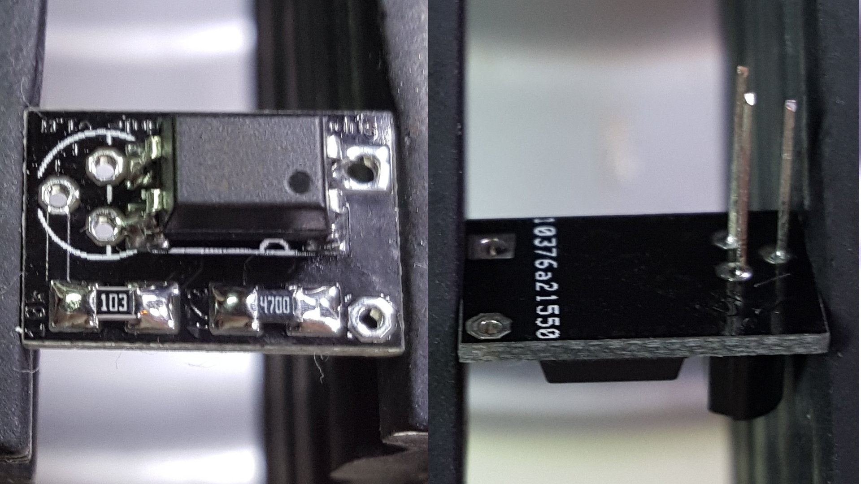
Images/Assembly Images/SaV64 Assembly 005.jpg
