SkydivinGirl/SaV64/Images/Assembly Images/SaV64 Assembly 006.jpg

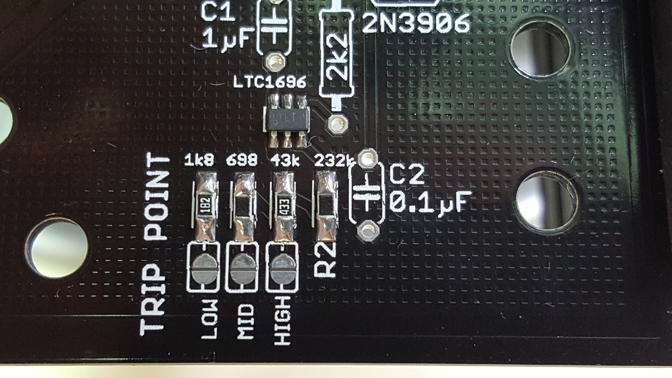
Images/Assembly Images/SaV64 Assembly 006.jpg
