SkydivinGirl/SaV64/Images/Assembly Images/SaV64 Assembly 008.jpg

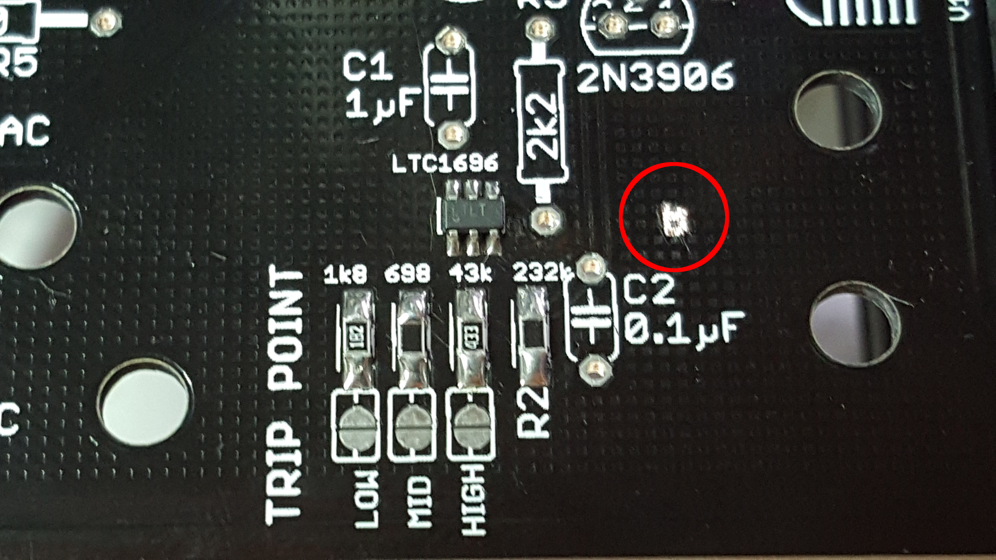
Images/Assembly Images/SaV64 Assembly 008.jpg
