SkydivinGirl/SaV64/Images/Assembly Images/SaV64 Assembly 009.jpg

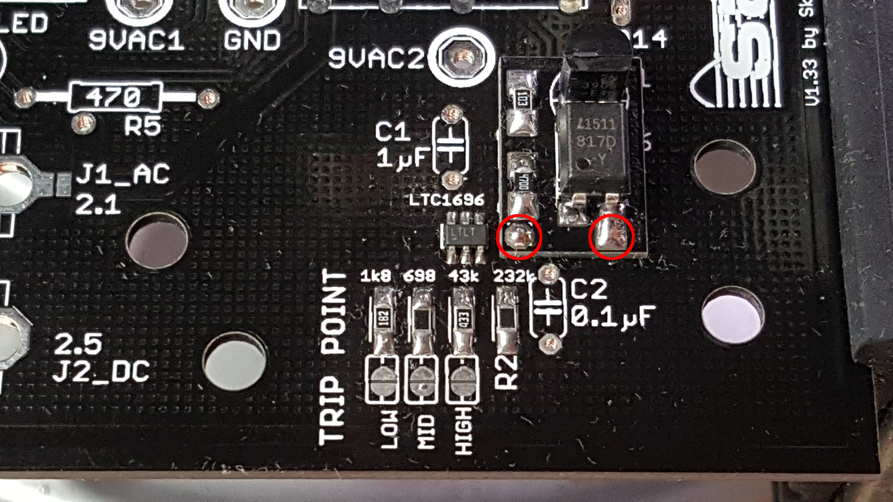
Images/Assembly Images/SaV64 Assembly 009.jpg
