SkydivinGirl/SaV64/Images/Assembly Images/SaV64 Assembly 014.jpg

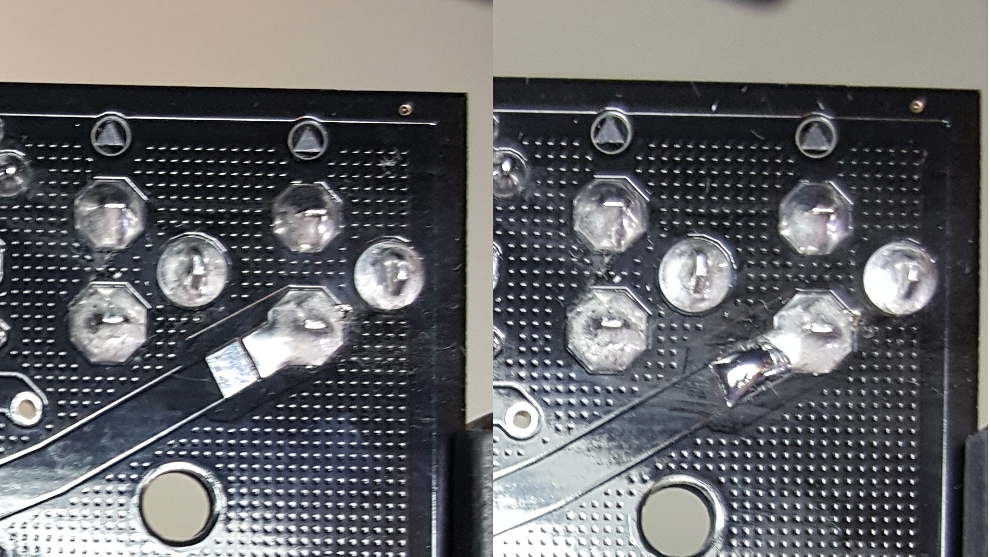
Images/Assembly Images/SaV64 Assembly 014.jpg
