SkydivinGirl/SaV64/Images/Assembly Images/SaV64 Assembly 015.jpg

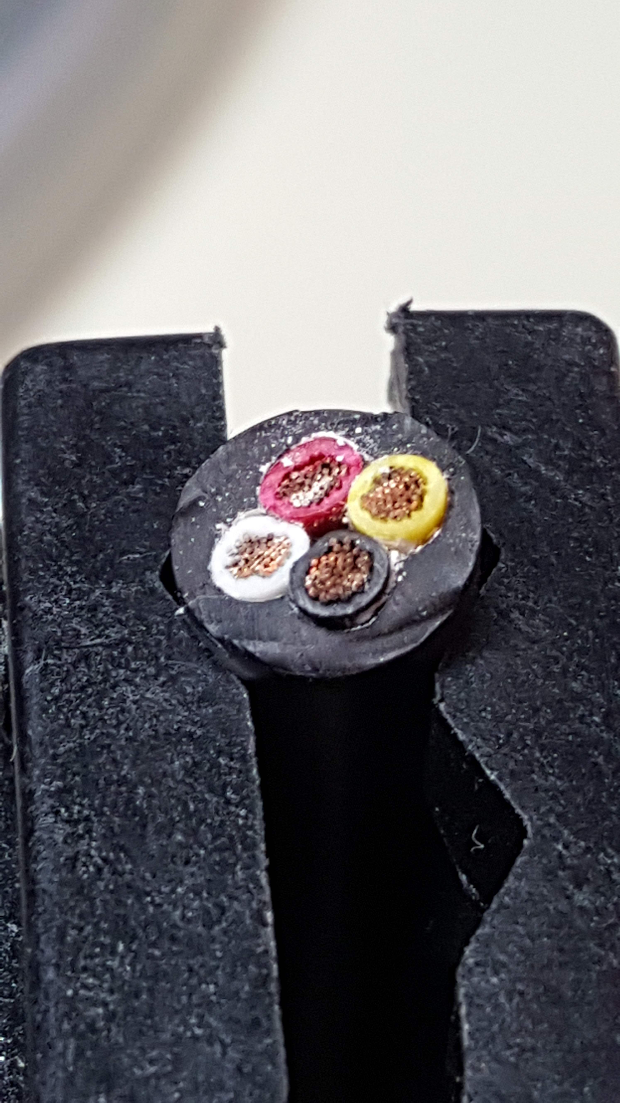
Images/Assembly Images/SaV64 Assembly 015.jpg
