SkydivinGirl/SaV64/Images/Assembly Images/SaV64 Assembly 016.jpg

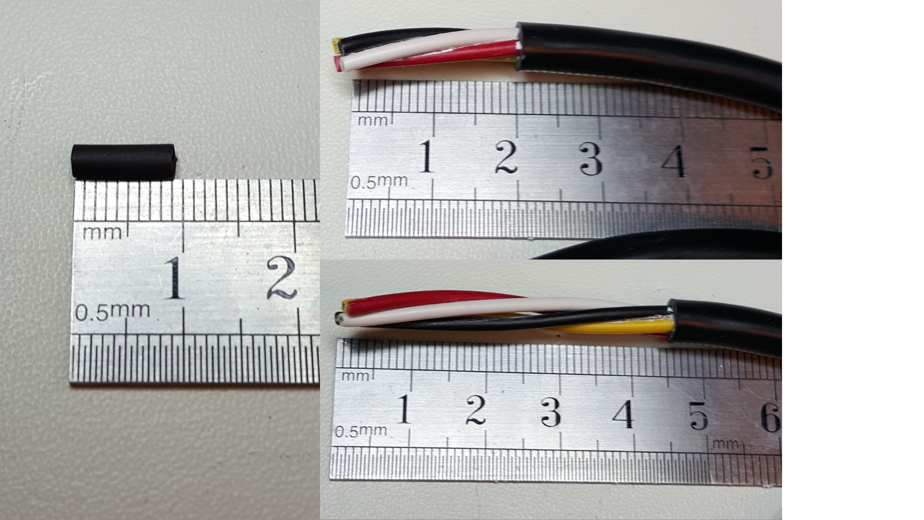
Images/Assembly Images/SaV64 Assembly 016.jpg
