SkydivinGirl/SaV64/Images/Assembly Images/SaV64 Assembly 017.jpg

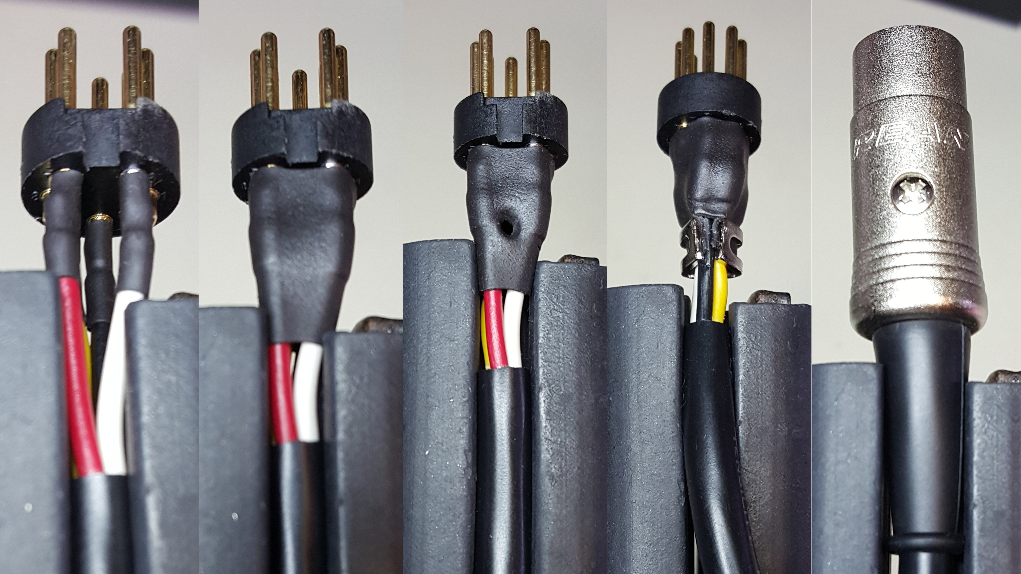
Images/Assembly Images/SaV64 Assembly 017.jpg
