SkydivinGirl/SaV64/Images/Assembly Images/SaV64 Assembly 020.jpg

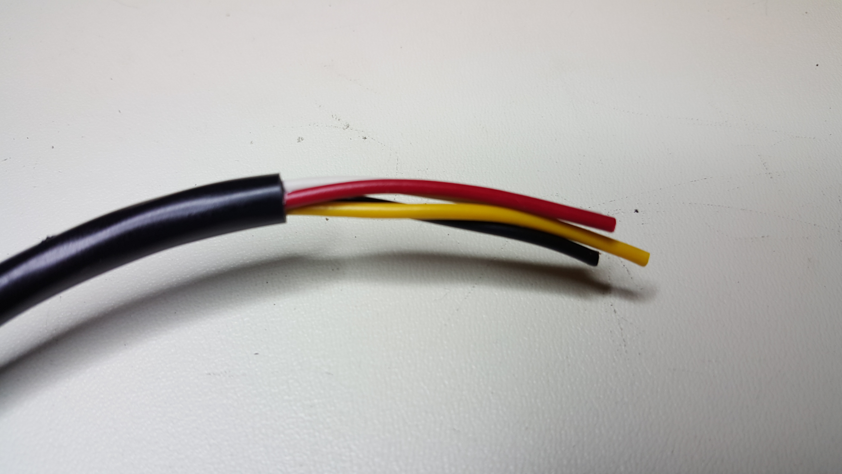
Images/Assembly Images/SaV64 Assembly 020.jpg
