SkydivinGirl/SaV64/Images/Assembly Images/SaV64 Assembly 022.jpg

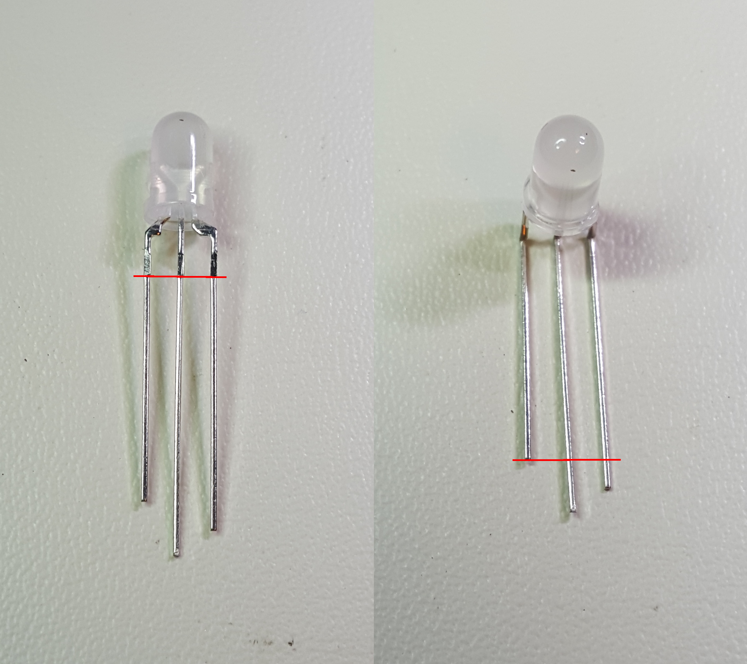
Images/Assembly Images/SaV64 Assembly 022.jpg
