SkydivinGirl/SaV64/Images/Assembly Images/SaV64 Assembly 028.jpg

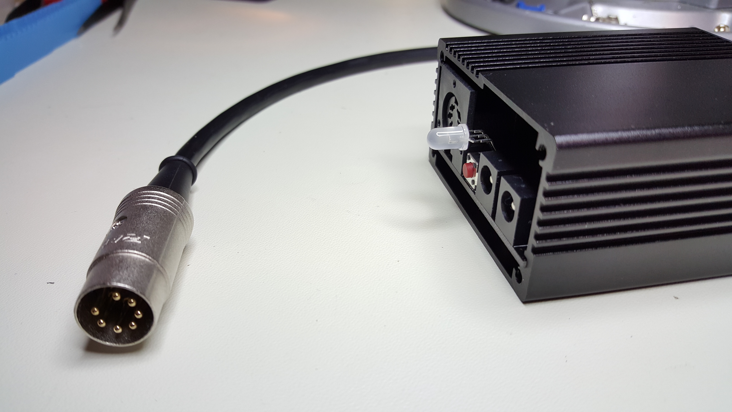
Images/Assembly Images/SaV64 Assembly 028.jpg
