SkydivinGirl/SaV64/(threads)

Thread 2 (2022-06-05):

Purchase options?

oemsysadm, 2022-06-05:
Hi, are these power savers for sale (preferably US based) any where that you know of?

SkydivinGirl, 2022-06-05:
As far as I know, I was the only person who ever produced this product. :(

Thank you,

Heather

-----Original Message-----
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

oemsysadm, 2022-06-06:
I dont suppose you still produce them? You should team up with Kevin Ottom,
he makes the nu-brick 64, an excellent c64 power supply.

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

SkydivinGirl, 2022-06-06:
I appreciate that you are interested in one.  The interest dropped off to the point where I ran out of parts and it would cost too much to do another run because the quantity would need to be much smaller.  I had to buy the aluminum cases in bulk to get them with the pre-cut holes for the SaV64 at a decent price.

Thank you,

Heather

-----Original Message-----
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
