SkydivinGirl/SaV64/PCBs/Oops v3/SaV64_v133_oops.brd

## EAGLE design PCBs/Oops v3/SaV64_v133_oops.brd (2019-05-26)

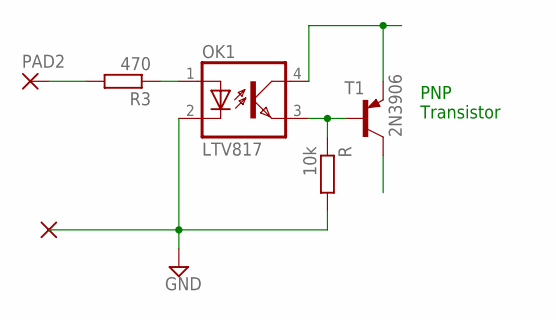
[picture p47: schematic SaV64_v133_oops.sch]

Parts:
OK1: LTV817; SMD4
PAD2: 1,6/0,8
R: 10k; R1210W
R3: 470; R1210W
T1: 2N3906; TO92

Connections:
GND: OK1.2 (C), R.2
unnamed: OK1.1 (A), R3.1
unnamed: OK1.3 (EMIT), R.1, T1.2 (B)
unnamed: PAD2.1, R3.2
unnamed: OK1.4 (COL), T1.3 (E)

Notes on the sheet:
PNP Transistor

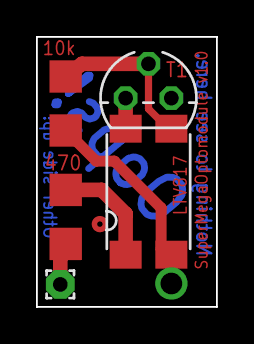
[picture p48: board SaV64_v133_oops.brd from above]

Board: 2 copper layers, 10.0 x 15.0 mm, 5 parts (0 on the bottom side), 5 nets.
