SkydivinGirl/SaV64/PCBs/v1.33/SaV64_v133.brd

## EAGLE design PCBs/v1.33/SaV64_v133.brd (2019-05-26, an earlier design)

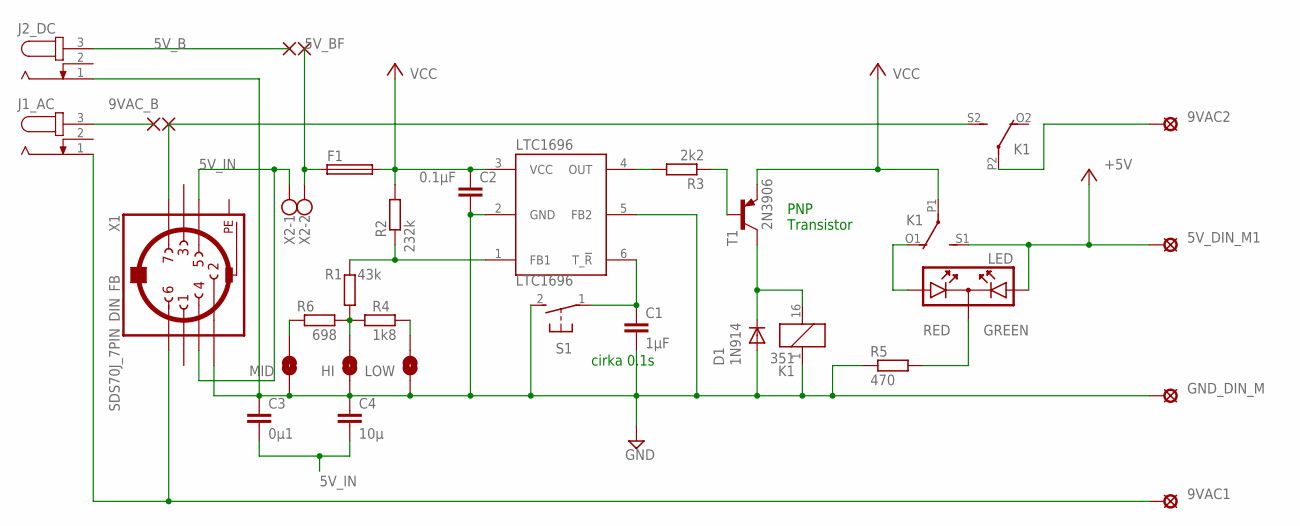
[picture p49: schematic SaV64_v133.sch]

Parts:
5V_DIN_M1, 9VAC1, 9VAC2: SE14
C1: 1µF; C050-024X044
C2: 0.1µF; C050-024X044
C3: 0µ1; C050-024X044
C4: 10µ; C050-024X044
D1: 1N914; DO35-10
F1: SHK20L
GND_DIN_M: SE14
HI: SJR; SJ_ROUNDED
J1_AC, J2_DC: JACK-PLUG0; SPC4077
K1: 351
LED: DUOLED
LOW: SJR; SJ_ROUNDED
LTC1696: LTC1696; SOT23-6
MID: SJR; SJ_ROUNDED
R1: 43k; R1206W
R2: 232k; R1206W
R3: 2k2; 0207/10
R4: 1k8; R1206W
R5: 470; 0207/12
R6: 698; R1206W
S1: 31-XX; B3F-31XX
T1: 2N3906; TO92
X1: SDS70J_7PIN_DIN_FB; SDS-70J_7PIN_FEMALE_DIN
X2: W237-102

Connections:
5V_B: J2_DC.3
5V_BF: F1.1A (1), F1.1B (1), X2.2
5V_IN: C3.2, C4.2, X1.4, X1.5, X2.1
9VAC2: 9VAC2.MP, K1.P2
9VAC_B: J1_AC.3
+5V: 5V_DIN_M1.MP, K1.S1 (S), LED.A1
GND: C1.2, C2.2, C3.1, C4.1, D1.A, GND_DIN_M.MP, HI.P$1 (1), J2_DC.1, K1.1, LOW.P$1 (1), LTC1696.2 (GND), LTC1696.5 (FB2), MID.P$1 (1), R5.1, S1.2 (S), X1.2
unnamed: LTC1696.1 (FB1), R1.2, R2.1
unnamed: LED.K, R5.2
unnamed: MID.P$2 (2), R6.1
unnamed: R3.1, T1.2 (B)
unnamed: HI.P$2 (2), R1.1, R4.2, R6.2
unnamed: C1.1, LTC1696.6 (T_!R), S1.1
unnamed: LTC1696.4 (OUT), R3.2
unnamed: K1.S2 (S), X1.7
unnamed: LOW.P$2 (2), R4.1
unnamed: K1.O1 (O), LED.A2
unnamed: D1.C, K1.16 (2), T1.1 (C)
unnamed: 9VAC1.MP, J1_AC.1, X1.6
PE: X1.PE, X1.PE@ (PE)
VCC: C2.1, F1.2A (2), F1.2B (2), K1.P1, LTC1696.3 (VCC), R2.2, T1.3 (E)

Notes on the sheet:
RED
GREEN
cirka 0.1s
PNP Transistor

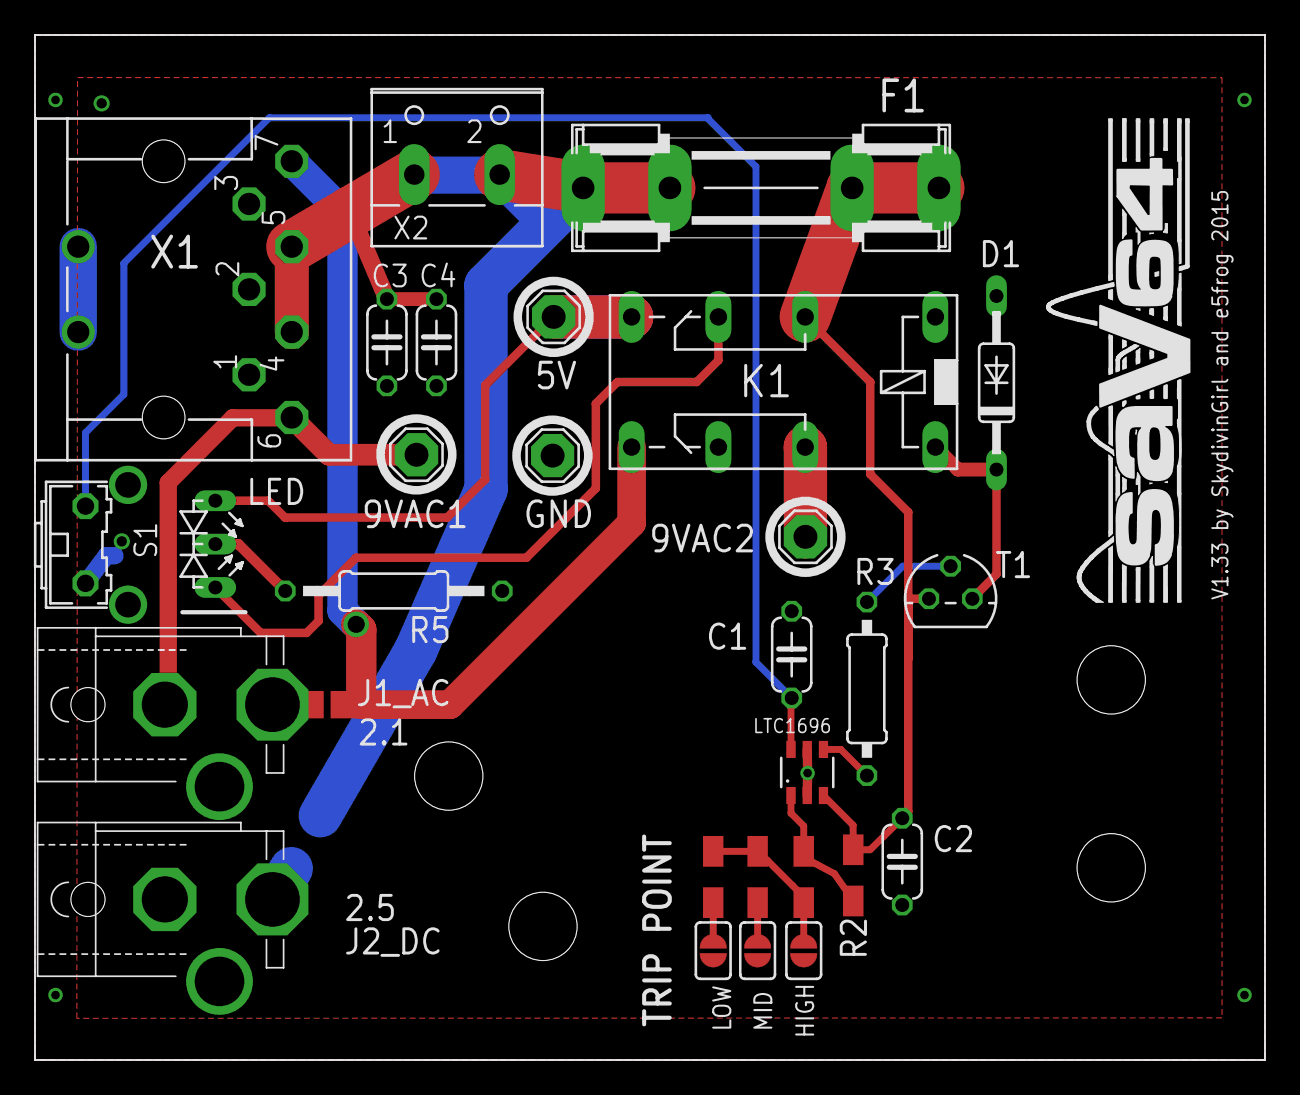
[picture p50: board SaV64_v133.brd from above]

Board: 2 copper layers, 72.0 x 60.0 mm, 28 parts (0 on the bottom side), 19 nets.
