SkydivinGirl/SaV64/(notices)

Notices in the files:
Documents/SaV64 Assembly - Commodore 64 (C64) Forum.htm:
Powered by <a href="http://www.phpbb.com/" target="_phpbb" class="copyright">phpBB</a> © 2001, 2005 phpBB Group<br />
