SkydivinGirl/SaV64/Images/Assembly Images/SaV64 Assembly 013.jpg

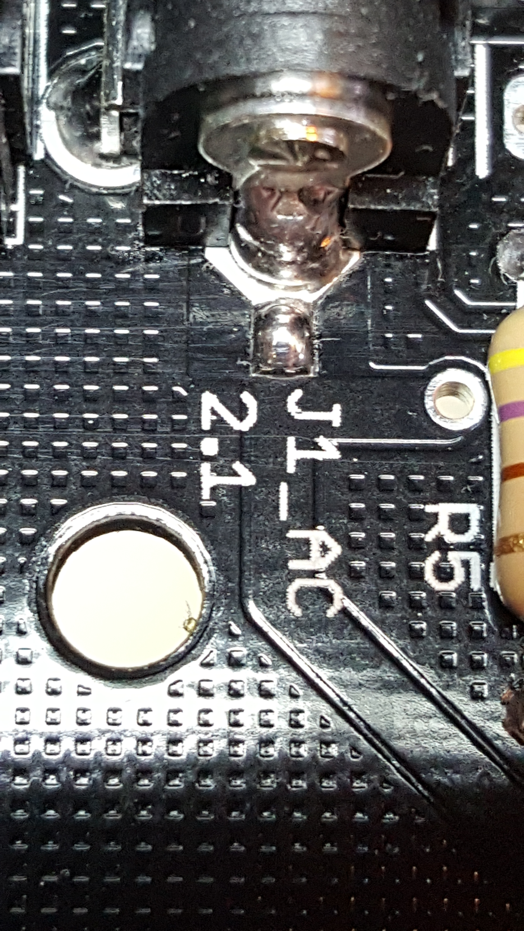
Images/Assembly Images/SaV64 Assembly 013.jpg
